leo-rsanchez/K-Vrc-desk-buddy/(notices)

Notices in the files:
README.md:
License: MIT
